JonFehl/Co2-Messgeraet/Bilder/GZ6_0649.JPG

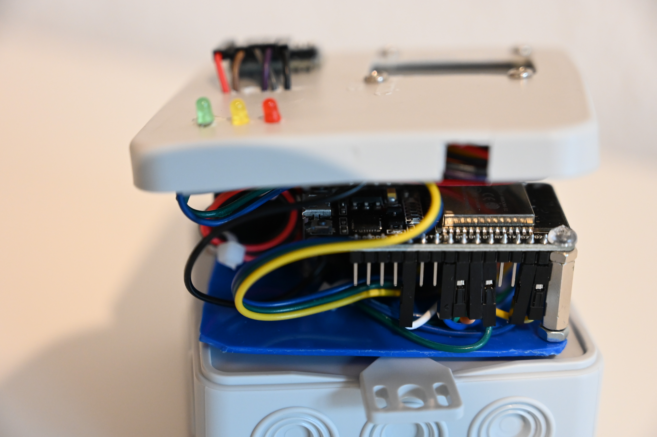
Bilder/GZ6_0649.JPG
