JonFehl/Co2-Messgeraet/Bilder/GZ6_0637.JPG

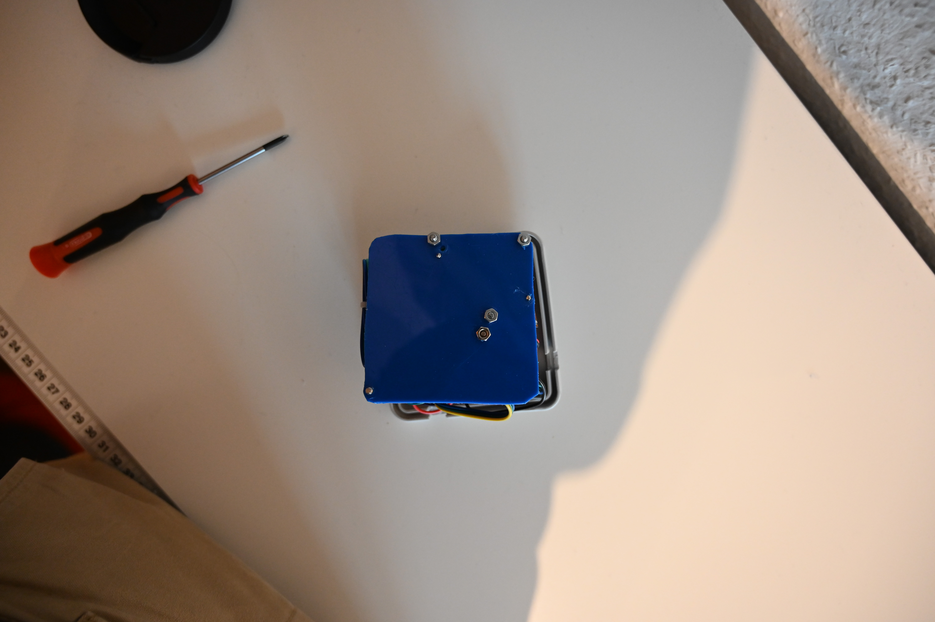
Bilder/GZ6_0637.JPG
