JonFehl/Co2-Messgeraet/Gehäuse.pdf

85

# 85 ¹¹ 11

45 30 30 44

### 30 Ø3 Display 1,3" 46

38 26 13

41 42 2

16

### 13 ¹⁰

### 15 Ø²

# Sensor 12,62

15 | 7 | 7

LED Ø2

13
