JonFehl/Co2-Messgeraet/Innenschablone.pdf

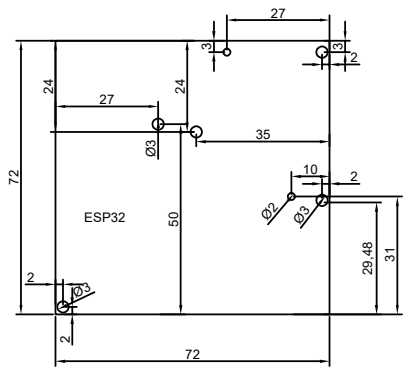
[picture p3: figure]
ESP32
