JonFehl/Co2-Messgeraet/Schaltplan ESP32.pdf

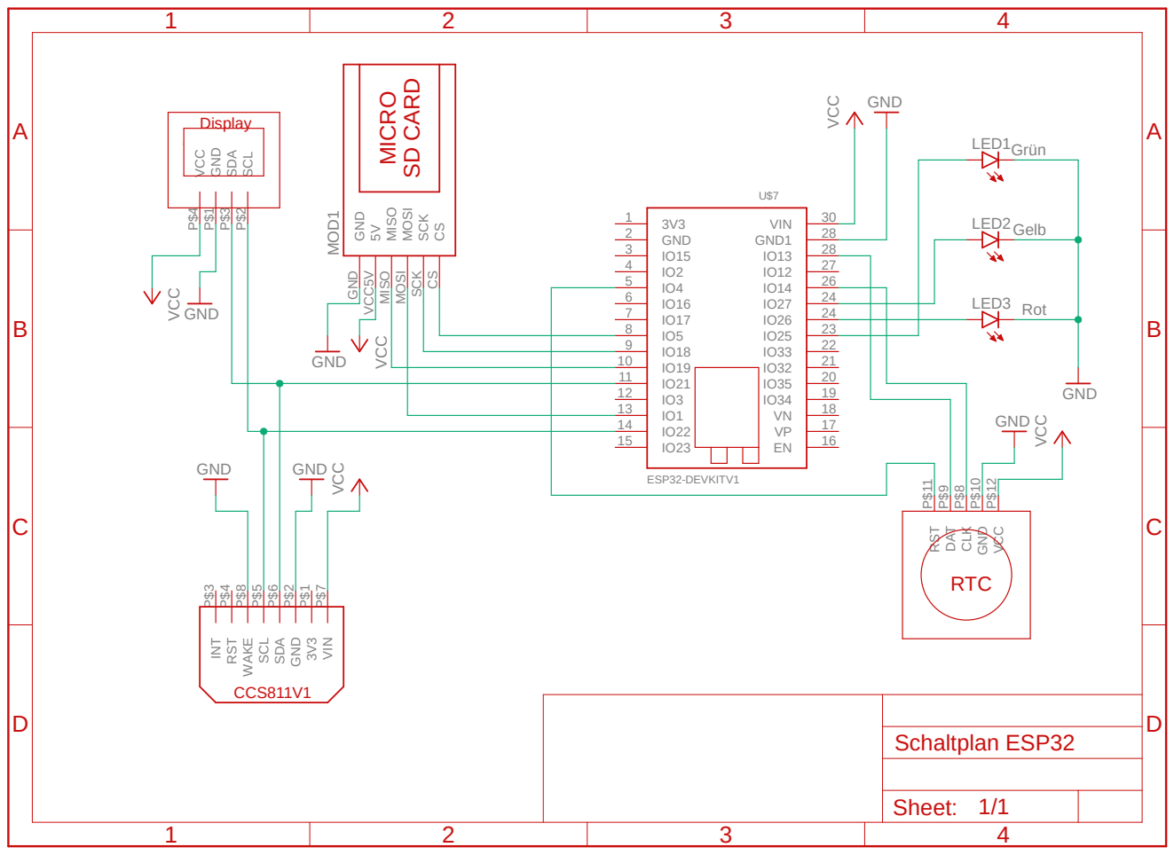
[picture p4: figure]
ESP32-DEVKITV1 VCC; VCC VCC VCC; VCC; GND; Grün; Gelb; GND 2; LED1; LED2; RTC; CCS811V1; MICRO SD CARD Display; Sheet:; Schaltplan ESP32

01.02.2021 17:33 D:\Studium\Hochschule Niederrhein\Master Elektrotechnik\PRO3\Schaltplan ESP32.sch (Sheet: 1/1)

Rot VIN P$7 3V³ P$1 GND P$2 SDA P$6 SCL P$5 WAKE P$8 RST P$4 INT P$3

IO23 15 | EN | 16 VP | 17 VN | 18 IO34 | 19 IO35 | 20 IO32 | 21 IO33 | 22 IO25 | 23 IO26 | 24 IO27 | 24 IO14 | 26 IO12 | 27 IO13 | 28 GND1 | 28 VIN | 30 U$7 GND GND 5V VCC⁵V | CS CS MOSI MOSI | SCK SCK MISO MISO MOD¹ VCC P$4 GND P$1 SDA P$3 SCL P$2
LED3 RST P$11 DAT P$9 | GND P$10 CLK P$8 | VCC P$12
