JonFehl/Co2-Messgeraet/Bilder/GZ6_0606.JPG

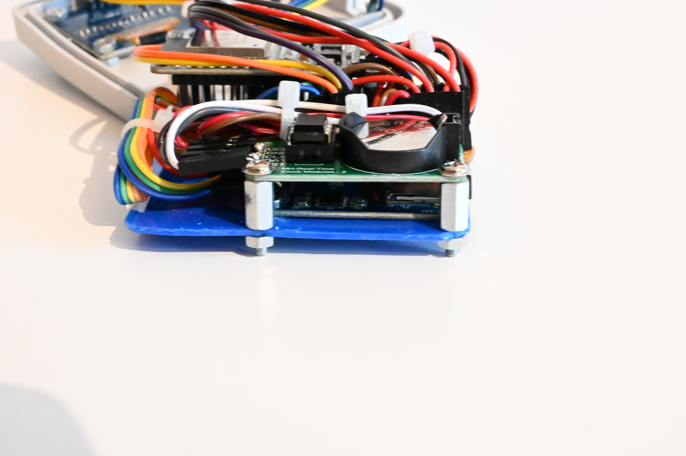
Bilder/GZ6_0606.JPG
