JonFehl/Co2-Messgeraet/Bilder/GZ6_0617.JPG

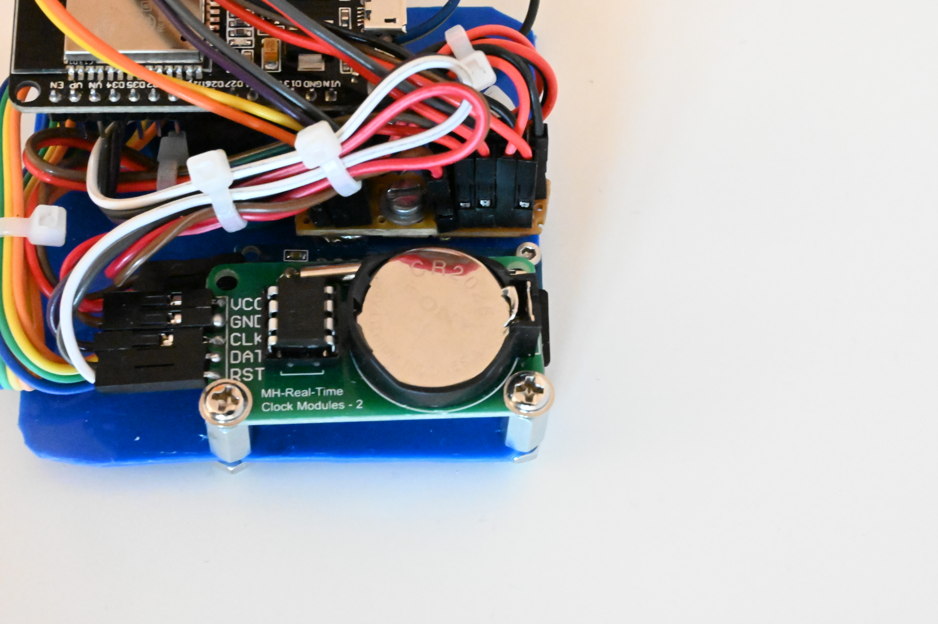
Bilder/GZ6_0617.JPG
