JonFehl/Co2-Messgeraet/Bilder/GZ6_0643.JPG

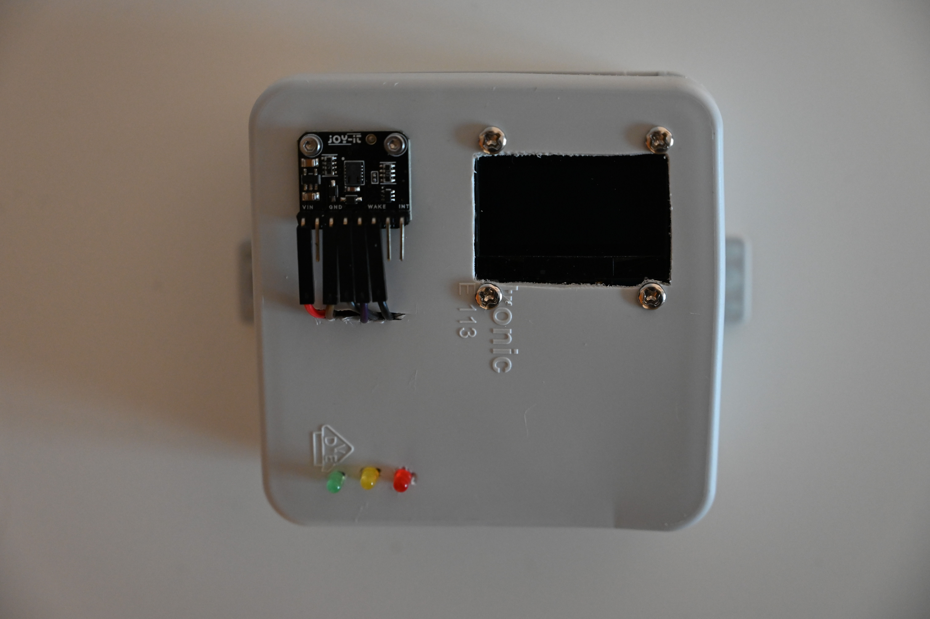
Bilder/GZ6_0643.JPG
