JonFehl/Co2-Messgeraet/Bilder/GZ6_0645.JPG

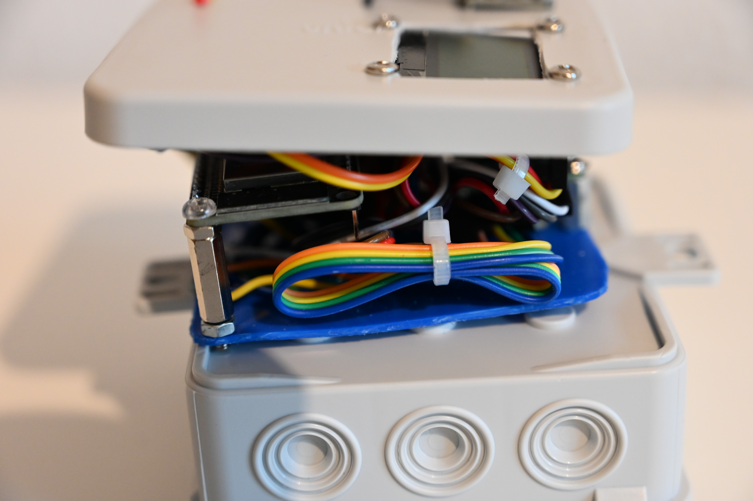
Bilder/GZ6_0645.JPG
