JonFehl/Co2-Messgeraet/Bilder/GZ6_0646.JPG

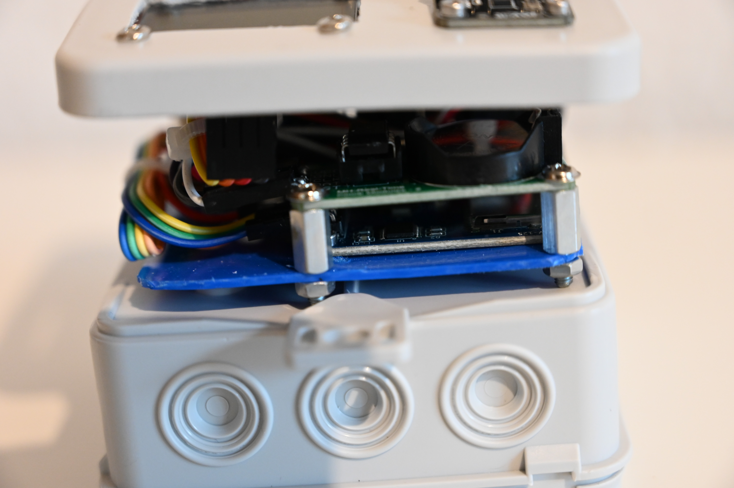
Bilder/GZ6_0646.JPG
