JonFehl/Co2-Messgeraet/Bilder/GZ6_0648.JPG

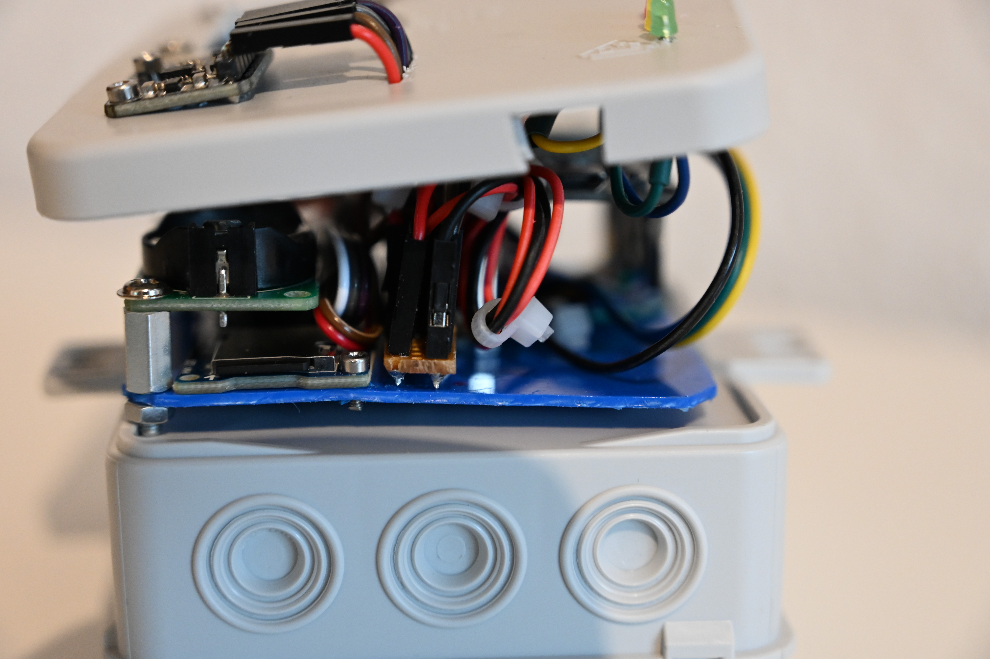
Bilder/GZ6_0648.JPG
